BreyndotEchse/nfc-spielbrett-pcb/spielbrett.kicad_pcb

## KiCad design spielbrett.kicad_pcb (2026-11-11)

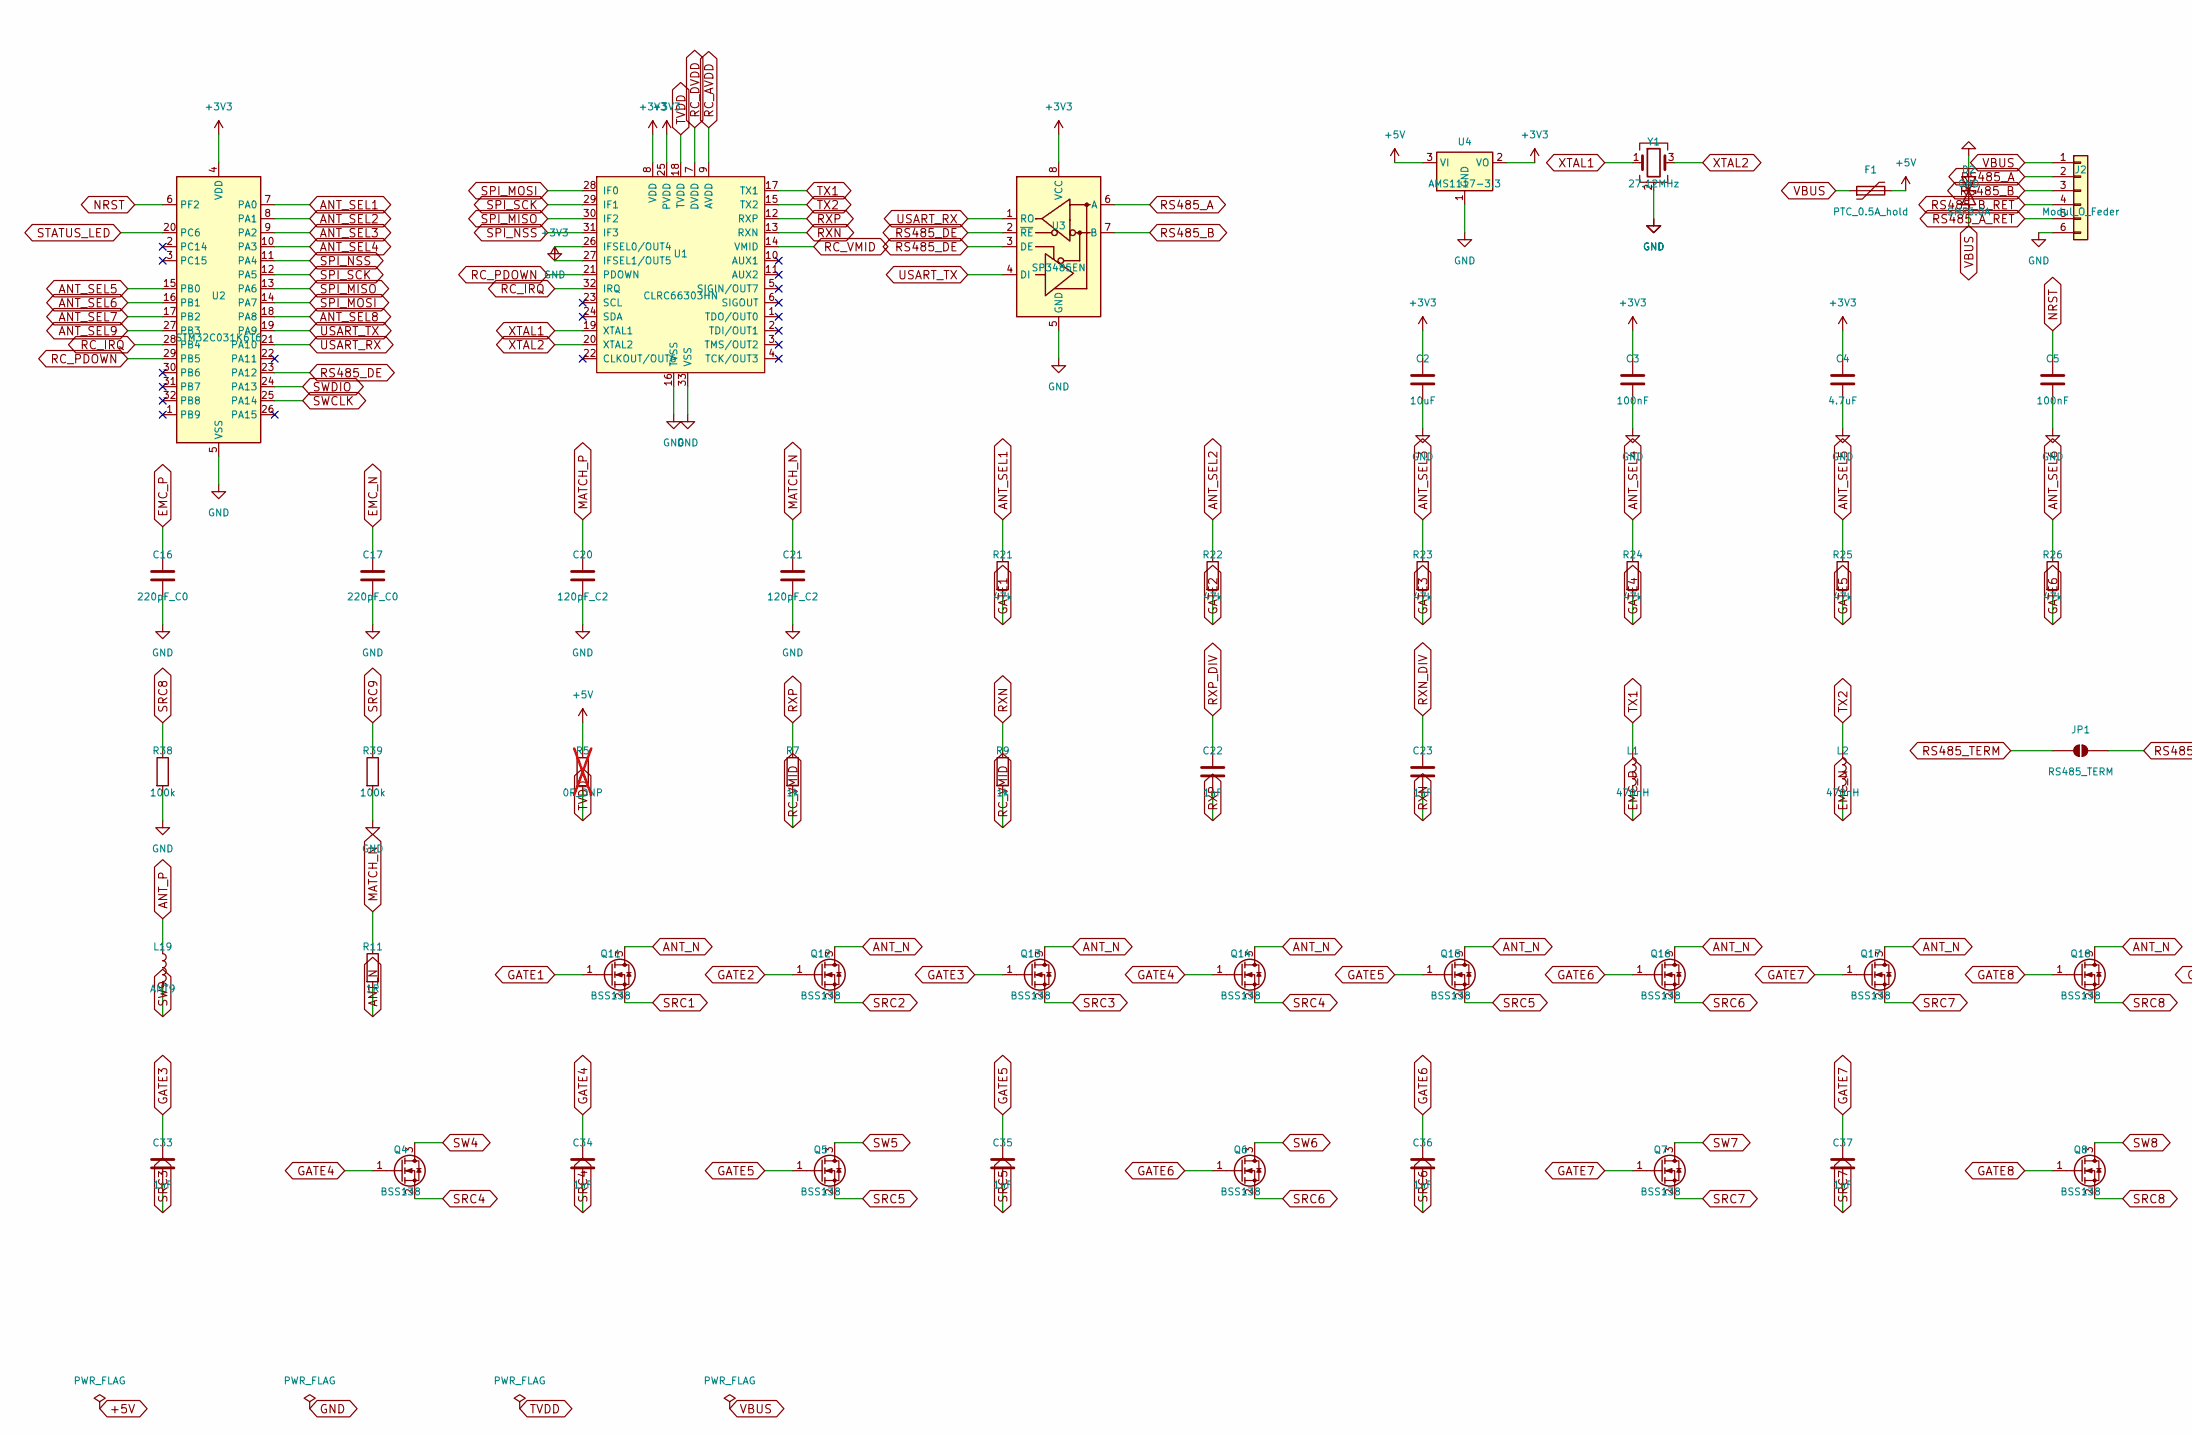
[picture p1: schematic spielbrett.kicad_sch, Spielbrett-Modul 3x3 NFC (147 x 147 mm), part in row 1, column 1]

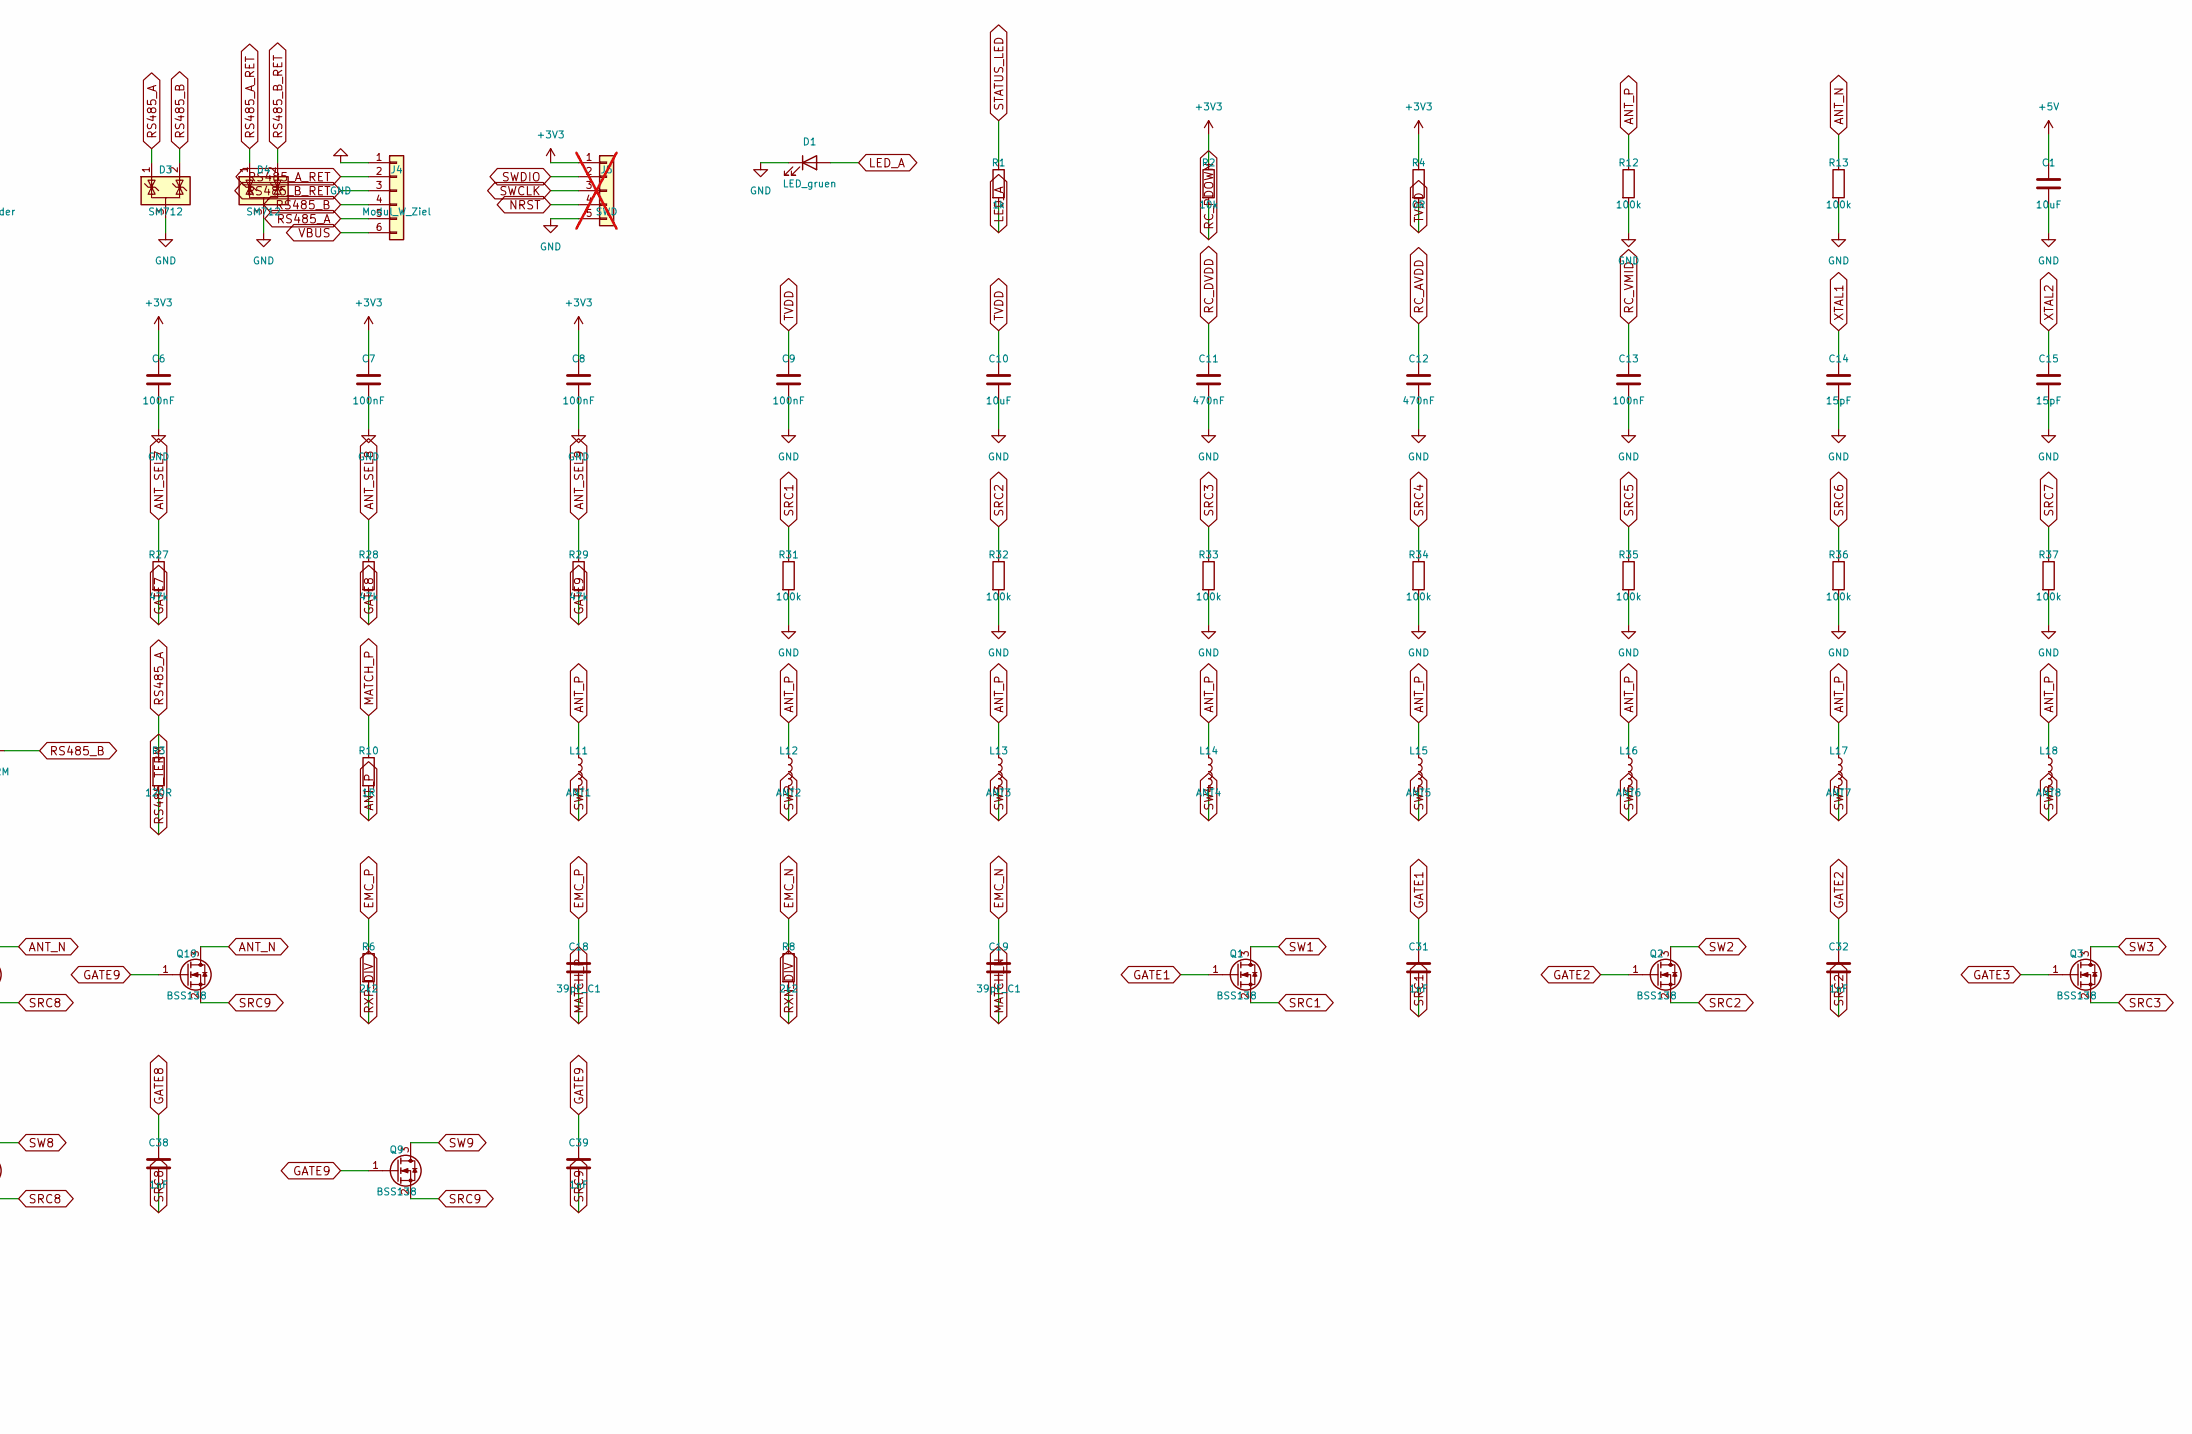
[picture p2: schematic spielbrett.kicad_sch, Spielbrett-Modul 3x3 NFC (147 x 147 mm), part in row 1, column 2]

Parts:
C1, C2, C10: 10uF; C_0805_2012Metric; LCSC C15850
C3, C5, C6, C7, C8, C9, C13: 100nF; C_0603_1608Metric; LCSC C14663
C4: 4.7uF; C_0603_1608Metric; LCSC C19666
C11, C12: 470nF; C_0603_1608Metric; LCSC C1623
C14, C15: 15pF; C_0603_1608Metric; LCSC C1644
C16, C17: 220pF_C0; C_0603_1608Metric; LCSC C106210
C18, C19: 39pF_C1; C_0603_1608Metric; LCSC C107049
C20, C21: 120pF_C2; C_0603_1608Metric; LCSC C107035
C22, C23, C31, C32, C33, C34, C35, C36, C37, C38, C39: 1nF; C_0603_1608Metric; LCSC C1588
D1: LED_gruen; LED_0603_1608Metric; LCSC C12624
D2: SMF5.0A; D_SOD-123F; LCSC C19077497
D3, D4: SM712; SOT-23; LCSC C521963
F1: PTC_0.5A_hold; Fuse_1206_3216Metric; LCSC C7542947
J2: Modul_O_Feder; HC-CX-PH254-1x6PW-4050B-E; MPN HC-CX-PH254-1x6PW-4050B-E; LCSC C56314391
J4: Modul_W_Ziel; HC-CX-FH254-1x6PW-4040B-E; MPN HC-CX-FH254-1x6PW-4040B-E; LCSC C56314419
J5: SWD; PinHeader_1x05_P1.27mm_Vertical; not fitted
JP1: RS485_TERM; SolderJumper-2_P1.3mm_Open_RoundedPad1.0x1.5mm
L1, L2: 470nH; L_0805_2012Metric; LCSC C412002
L11: ANT1; NFC_Coil_D24_N5_W0.4_S0.4
L12: ANT2; NFC_Coil_D24_N5_W0.4_S0.4
L13: ANT3; NFC_Coil_D24_N5_W0.4_S0.4
L14: ANT4; NFC_Coil_D24_N5_W0.4_S0.4
L15: ANT5; NFC_Coil_D24_N5_W0.4_S0.4
L16: ANT6; NFC_Coil_D24_N5_W0.4_S0.4
L17: ANT7; NFC_Coil_D24_N5_W0.4_S0.4
L18: ANT8; NFC_Coil_D24_N5_W0.4_S0.4
L19: ANT9; NFC_Coil_D24_N5_W0.4_S0.4
Q1, Q2, Q3, Q4, Q5, Q6, Q7, Q8, Q9, Q11, Q12, Q13, Q14, Q15, Q16, Q17, Q18, Q19: BSS138; SOT-23; LCSC C7420339
R1, R7, R9: 1k; R_0603_1608Metric; LCSC C21190
R2: 10k; R_0603_1608Metric; LCSC C25804
R3: 120R; R_0603_1608Metric; LCSC C22787
R4: 0R; R_0805_2012Metric; LCSC C17477
R5: 0R_DNP; R_0805_2012Metric; LCSC C17477; not fitted
R6, R8: 2k2; R_0603_1608Metric; LCSC C4190
R10, R11: 1R; R_0603_1608Metric; LCSC C22936
R12, R13, R31, R32, R33, R34, R35, R36, R37, R38, R39: 100k; R_0603_1608Metric; LCSC C25803
R21, R22, R23, R24, R25, R26, R27, R28, R29: 47k; R_0603_1608Metric; LCSC C25819
U1: CLRC66303HN; HVQFN-32-1EP_5x5mm_P0.5mm_EP3.1x3.1mm; MPN CLRC66303HNY; LCSC C2988350
U2: STM32C031K6T6; LQFP-32_7x7mm_P0.8mm; MPN STM32C031K6T6; LCSC C5456169
U3: SP3485EN; SOIC-8_3.9x4.9mm_P1.27mm; MPN SP3485EN-L/TR; LCSC C8963
U4: AMS1117-3.3; SOT-223-3_TabPin2; LCSC C6186
Y1: 27.12MHz; Crystal_SMD_3225-4Pin_3.2x2.5mm; LCSC C29975

Connections:
+3V3: C2.1, C3.1, C4.1, C6.1, C7.1, C8.1, J5.1, R2.1, R4.1, U1.8 (VDD), U1.25 (PVDD), U1.27 (IFSEL1/OUT5), U2.4 (VDD), U3.8 (VCC), U4.2 (VO)
+5V: C1.1, F1.2, R5.1, U4.3 (VI)
ANT_N: Q11.3 (D), Q12.3 (D), Q13.3 (D), Q14.3 (D), Q15.3 (D), Q16.3 (D), Q17.3 (D), Q18.3 (D), Q19.3 (D), R11.2, R13.1
ANT_P: L11.1, L12.1, L13.1, L14.1, L15.1, L16.1, L17.1, L18.1, L19.1, R10.2, R12.1
ANT_SEL1: R21.1, U2.7 (PA0)
ANT_SEL2: R22.1, U2.8 (PA1)
ANT_SEL3: R23.1, U2.9 (PA2)
ANT_SEL4: R24.1, U2.10 (PA3)
ANT_SEL5: R25.1, U2.15 (PB0)
ANT_SEL6: R26.1, U2.16 (PB1)
ANT_SEL7: R27.1, U2.17 (PB2)
ANT_SEL8: R28.1, U2.18 (PA8)
ANT_SEL9: R29.1, U2.27 (PB3)
EMC_N: C17.1, C19.1, L2.2, R8.1
EMC_P: C16.1, C18.1, L1.2, R6.1
GATE1: C31.1, Q1.1 (G), Q11.1 (G), R21.2
GATE2: C32.1, Q2.1 (G), Q12.1 (G), R22.2
GATE3: C33.1, Q3.1 (G), Q13.1 (G), R23.2
GATE4: C34.1, Q4.1 (G), Q14.1 (G), R24.2
GATE5: C35.1, Q5.1 (G), Q15.1 (G), R25.2
GATE6: C36.1, Q6.1 (G), Q16.1 (G), R26.2
GATE7: C37.1, Q7.1 (G), Q17.1 (G), R27.2
GATE8: C38.1, Q8.1 (G), Q18.1 (G), R28.2
GATE9: C39.1, Q9.1 (G), Q19.1 (G), R29.2
GND: C1.2, C2.2, C3.2, C4.2, C5.2, C6.2, C7.2, C8.2, C9.2, C10.2, C11.2, C12.2, C13.2, C14.2, C15.2, C16.2, C17.2, C20.2, C21.2, D1.1 (K), D2.2 (A2), D3.3 (A), D4.3 (A), J2.6, J4.1, J5.5, R12.2, R13.2, R31.2, R32.2, R33.2, R34.2, R35.2, R36.2, R37.2, R38.2, R39.2, U1.16 (TVSS), U1.26 (IFSEL0/OUT4), U1.33 (VSS), U2.5 (VSS), U3.5 (GND), U4.1 (GND), Y1.2 (G), Y1.4 (G)
LED_A: D1.2 (A), R1.2
MATCH_N: C19.2, C21.1, R11.1
MATCH_P: C18.2, C20.1, R10.1
NRST: C5.1, J5.4, U2.6 (PF2)
RC_AVDD: C12.1, U1.9 (AVDD)
RC_DVDD: C11.1, U1.7 (DVDD)
RC_IRQ: U1.32 (IRQ), U2.28 (PB4)
RC_PDOWN: R2.2, U1.21 (PDOWN), U2.29 (PB5)
RC_VMID: C13.1, R7.2, R9.2, U1.14 (VMID)
RS485_A: D3.1 (K), J2.2, J4.5, R3.1, U3.6 (A)
RS485_A_RET: D4.1 (K), J2.5, J4.2
RS485_B: D3.2 (K), J2.3, J4.4, JP1.2 (B), U3.7 (B)
RS485_B_RET: D4.2 (K), J2.4, J4.3
RS485_DE: U2.23 (PA12), U3.2 (~RE), U3.3 (DE)
RS485_TERM: JP1.1 (A), R3.2
RXN: C23.2, R9.1, U1.13 (RXN)
RXN_DIV: C23.1, R8.2
RXP: C22.2, R7.1, U1.12 (RXP)
RXP_DIV: C22.1, R6.2
SPI_MISO: U1.30 (IF2), U2.13 (PA6)
SPI_MOSI: U1.28 (IF0), U2.14 (PA7)
SPI_NSS: U1.31 (IF3), U2.11 (PA4)
SPI_SCK: U1.29 (IF1), U2.12 (PA5)
SRC1: C31.2, Q1.2 (S), Q11.2 (S), R31.1
SRC2: C32.2, Q2.2 (S), Q12.2 (S), R32.1
SRC3: C33.2, Q3.2 (S), Q13.2 (S), R33.1
SRC4: C34.2, Q4.2 (S), Q14.2 (S), R34.1
SRC5: C35.2, Q5.2 (S), Q15.2 (S), R35.1
SRC6: C36.2, Q6.2 (S), Q16.2 (S), R36.1
SRC7: C37.2, Q7.2 (S), Q17.2 (S), R37.1
SRC8: C38.2, Q8.2 (S), Q18.2 (S), R38.1
SRC9: C39.2, Q9.2 (S), Q19.2 (S), R39.1
STATUS_LED: R1.1, U2.20 (PC6)
SW1: L11.2, Q1.3 (D)
SW2: L12.2, Q2.3 (D)
SW3: L13.2, Q3.3 (D)
SW4: L14.2, Q4.3 (D)
SW5: L15.2, Q5.3 (D)
SW6: L16.2, Q6.3 (D)
SW7: L17.2, Q7.3 (D)
SW8: L18.2, Q8.3 (D)
SW9: L19.2, Q9.3 (D)
SWCLK: J5.3, U2.25 (PA14)
SWDIO: J5.2, U2.24 (PA13)
TX1: L1.1, U1.17 (TX1)
TX2: L2.1, U1.15 (TX2)
USART_RX: U2.21 (PA10), U3.1 (RO)
USART_TX: U2.19 (PA9), U3.4 (DI)
XTAL1: C14.1, U1.19 (XTAL1), Y1.1
XTAL2: C15.1, U1.20 (XTAL2), Y1.3

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
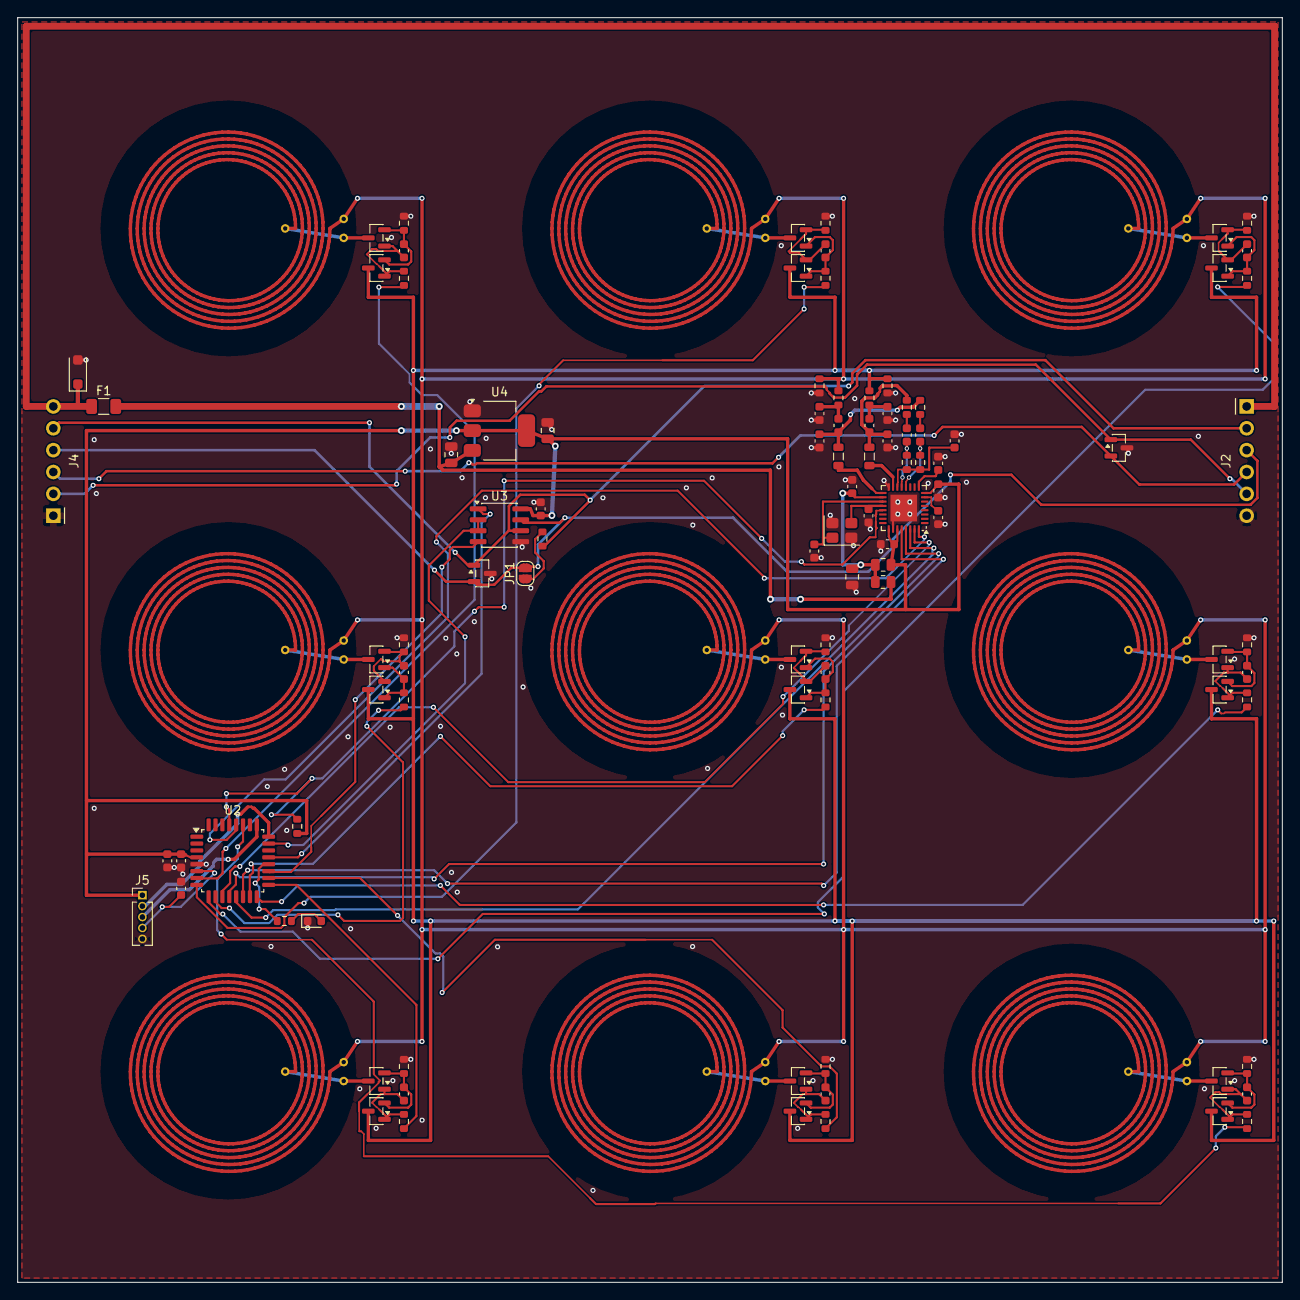
[picture p3: board spielbrett.kicad_pcb from above]

Board: 2 copper layers, 147.0 x 147.0 mm, 106 parts (0 on the bottom side), 77 nets.
