BreyndotEchse/nfc-spielbrett-pcb/(commit log)

2026-11-11 Modulkontakte HC-CX, RS485-Ringbus und Routing-Pipeline
    - J1/J3 entfernt; J2 (Ost, Federseite) und J4 (West, Zielseite) als
    6-polige magnetische Pogo-Stecker Hong Cheng HC-CX ...-E
    - RS485 als linearer Bus mit Rueckleitung (RS485_A_RET/B_RET), die
    Endkappe schliesst den Kreis; VBUS mit PTC F1, TVS D2, ESD D3/D4
    - tools/stecker.py: Footprints der Steckervarianten erzeugen und im
    Schaltplan umschalten (gleiches Lochbild, Tausch per F8)
    - tools/stecker_3d.py: parametrische STEP-Modelle (build123d)
    - beide Generatoren erzeugen reproduzierbare Dateien
    - tools/route_escape.py, tools/autoroute.py: Fanout und headless
    Freerouting; Pipeline ergibt DRC 0/0/0
    - production/ (Fabrication Toolkit)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
    [spielbrett.kicad_pcb, spielbrett.kicad_sch]
2026-11-11 LCSC-Nummern fuer alle Bauteile, J5 nicht bestuecken
    - Alle Bauteile ausser J5 tragen ein LCSC-Feld (Schaltplan und
    Platine), geprueft gegen die JLC-Teileliste
    - Korrekturen gegenueber der automatischen JLC-Zuordnung:
    C16/C17 C106210 (NP0 statt X7R), D1 C12624 (gruen statt rot),
    Y1 C29975 (3225 mit 10 pF statt 2016)
    - J5 (SWD) auf DNP, wird nicht bestueckt
    [spielbrett.kicad_pcb, spielbrett.kicad_sch]
